Yangtiayan/High-Voltage-Three-Phase-Current-Detection-System-Based-on-MPF66200/(list of files, drawings)

Other design files:
ProPrj_Isolated Current Sensing_latest_2025-08-29.epro
